uzzambutt/NorthernStudios-RX-Micro-ELRS-Receiver-2.4GHz/Schematic/NS ELRS RX MICRO.pdf

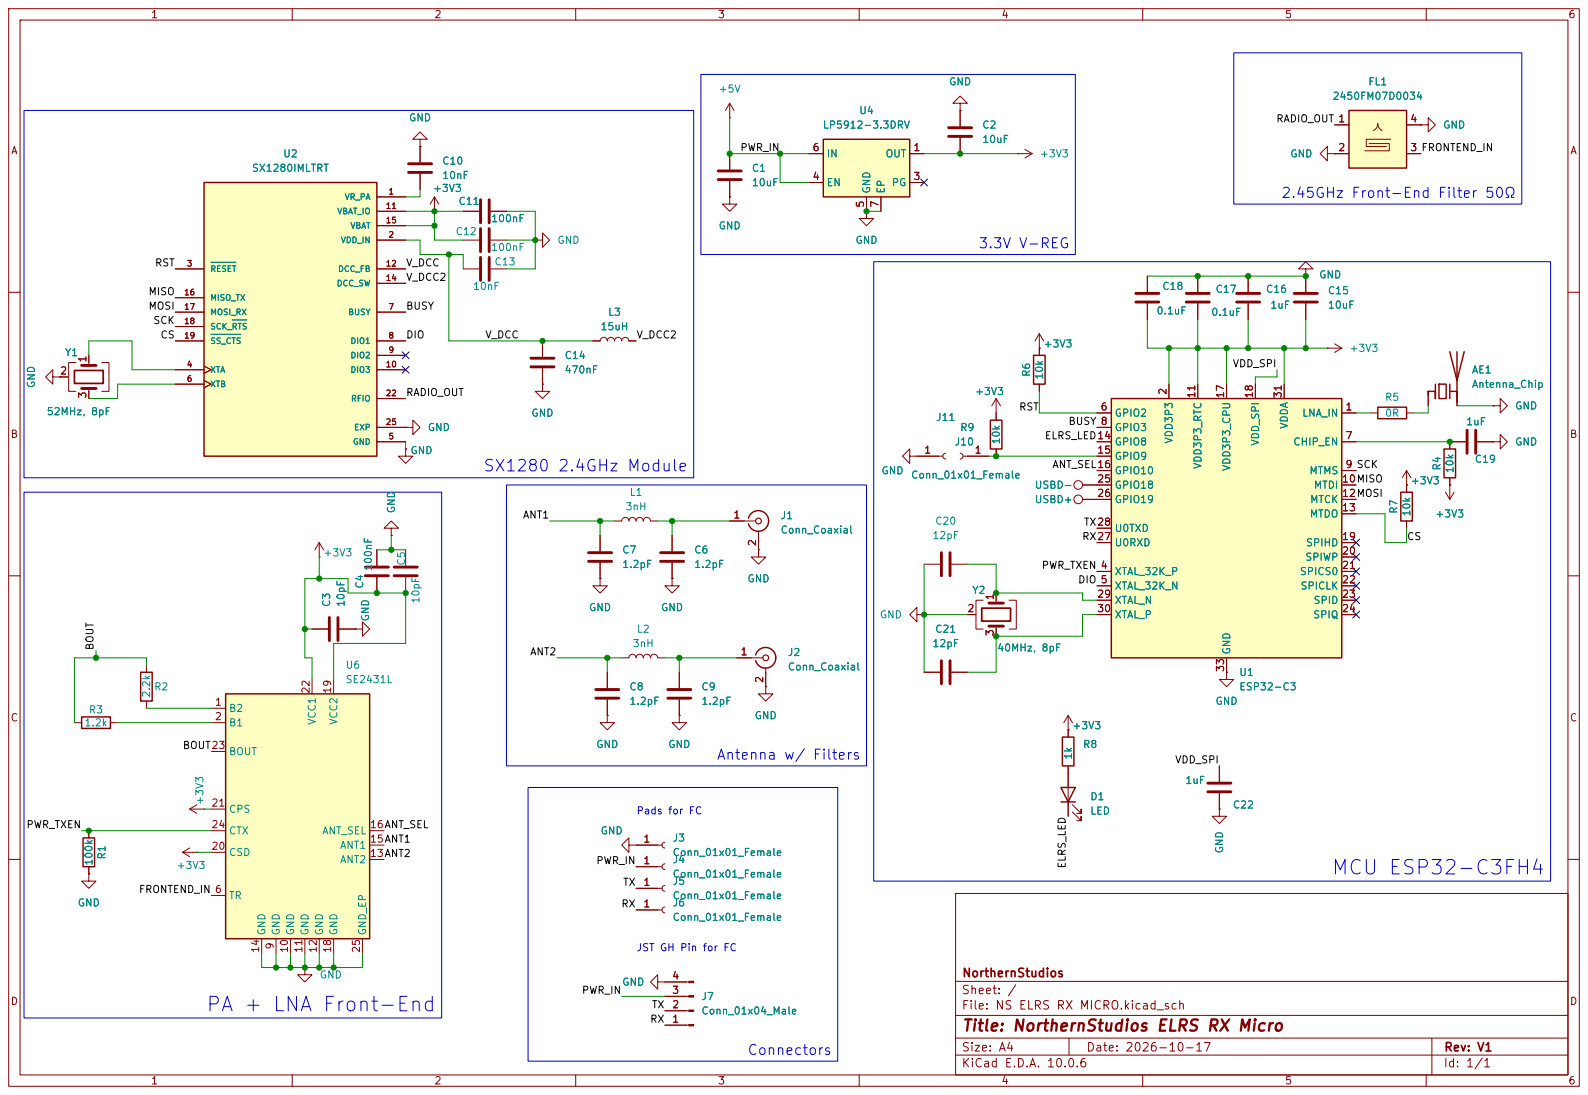
[picture p5: page 1]

CS RST MOSI MISO

JST GH Pin for FC

NorthernStudios
Sheet: /
File: NS ELRS RX MICRO.kicad_sch
Title: NorthernStudios ELRS RX Micro

PA + LNA Front-End

Size: A4 | Rev: V1
KiCad E.D.A. 10.0.6 | Id: 1/1
