uzzambutt/NorthernStudios-RX-Micro-ELRS-Receiver-2.4GHz/NS ELRS RX MICRO.kicad_pcb

## KiCad design NS ELRS RX MICRO.kicad_pcb (2026-10-26)

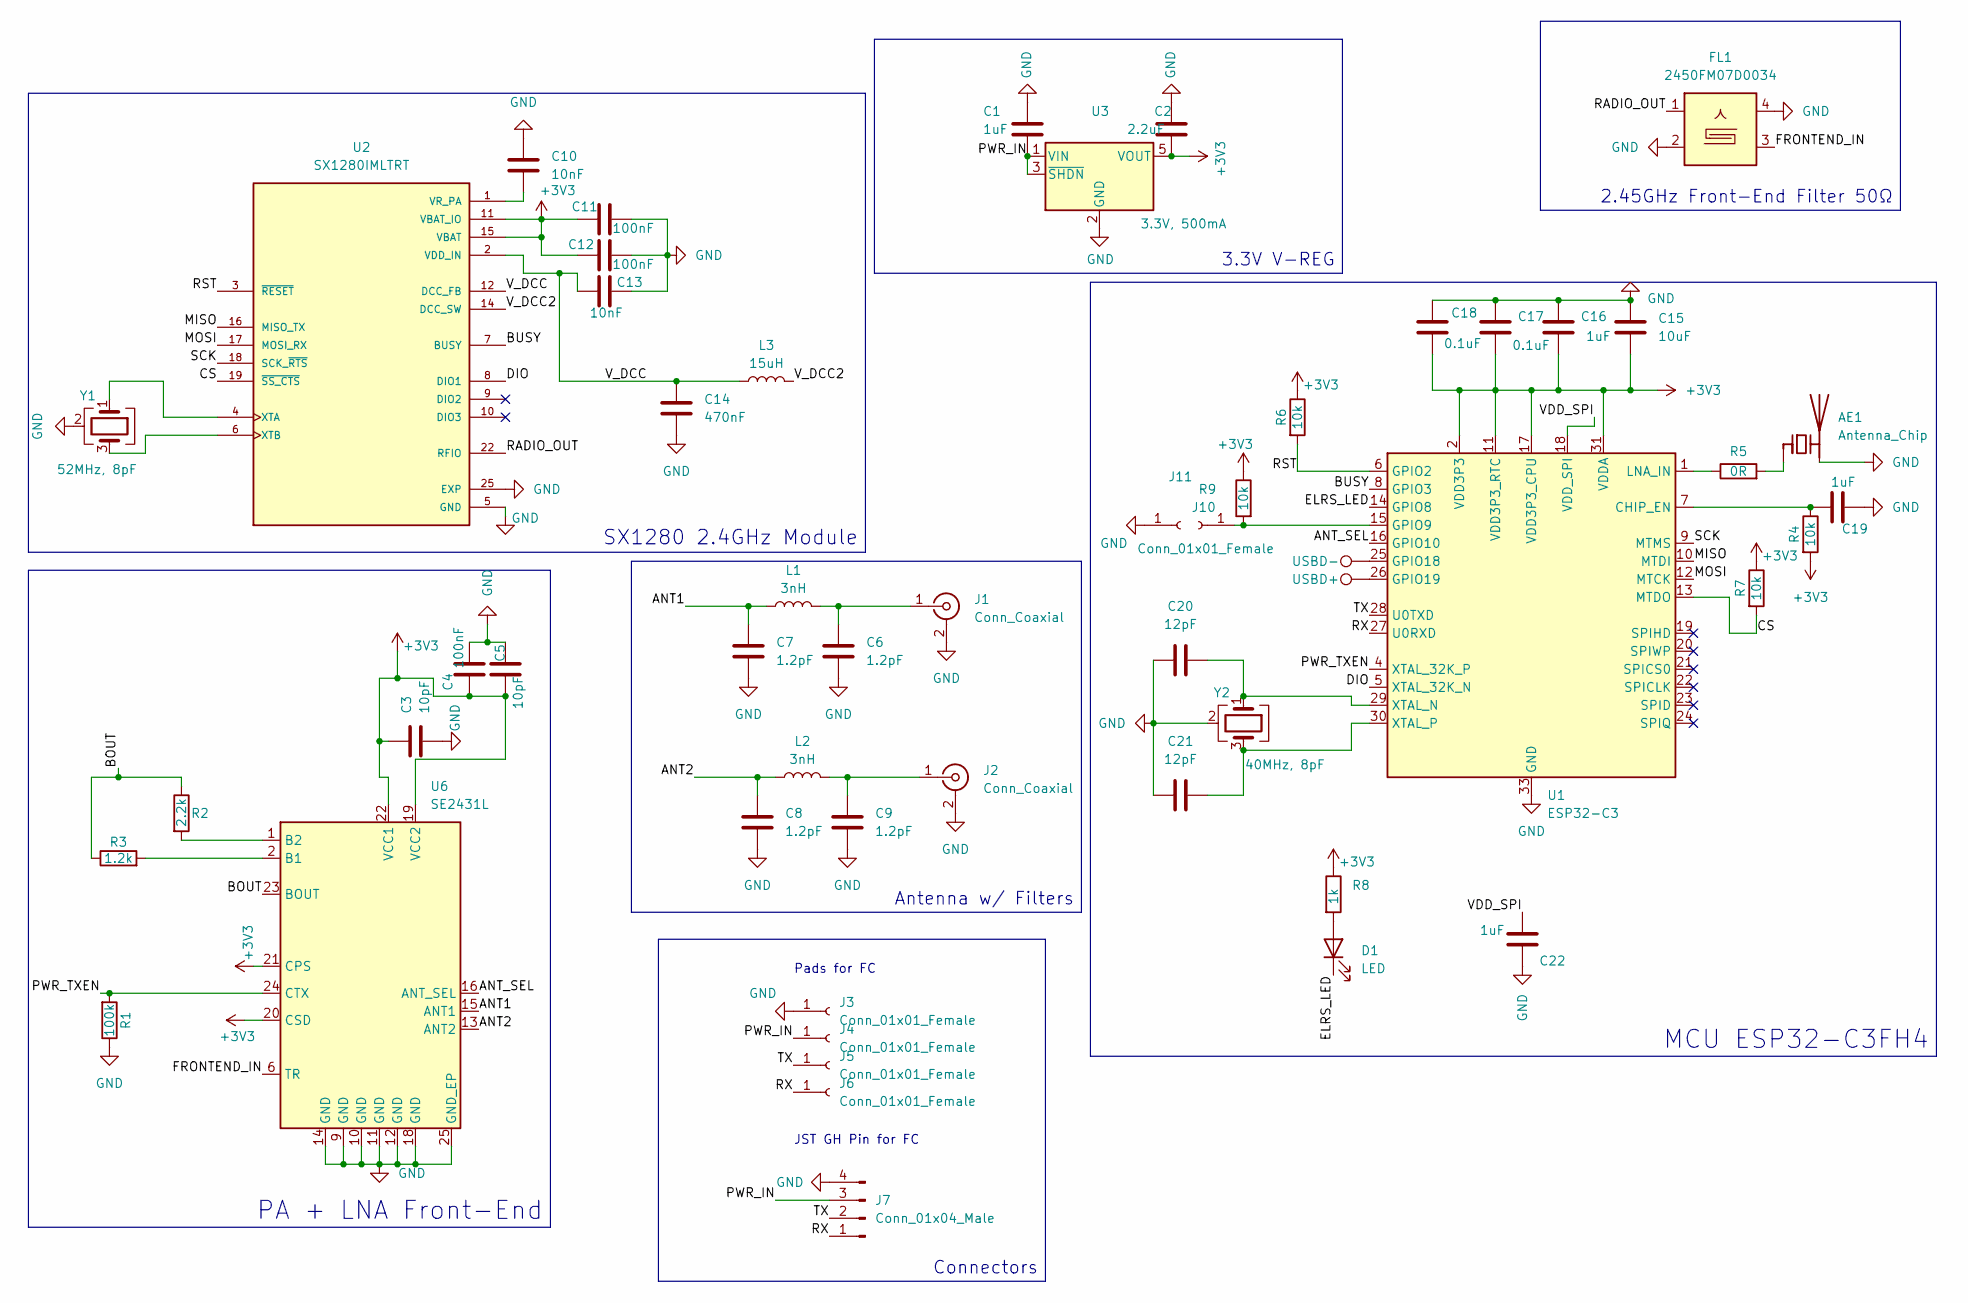
[picture p6: schematic NS ELRS RX MICRO.kicad_sch, NorthernStudios ELRS RX Micro]

Parts:
AE1: Antenna_Chip; Johanson_2450AT18x100
C1: 1uF; C_0402_1005Metric; LCSC C52923
C2: 2.2uF; C_0402_1005Metric; LCSC C12530
C3, C5: 10pF; C_0402_1005Metric
C4, C11, C12: 100nF; C_0402_1005Metric
C6, C7, C8, C9: 1.2pF; C_0402_1005Metric
C10, C13: 10nF; C_0402_1005Metric
C14: 470nF; C_0402_1005Metric
C15: 10uF; C_0402_1005Metric
C16, C19, C22: 1uF; C_0402_1005Metric
C17, C18: 0.1uF; C_0402_1005Metric
C20, C21: 12pF; C_0402_1005Metric
D1: LED; LED_0603_1608Metric
FL1: 2450FM07D0034
J1, J2: Conn_Coaxial; U.FL_Hirose_U.FL-R-SMT-1_Vertical
J3, J4, J5, J6: Conn_01x01_Female; TestPoint_Pad_2.5x2.5mm
J7: Conn_01x04_Male; JST_GH_SM04B-GHS-TB_1x04-1MP_P1.25mm_Horizontal; LCSC C189895
J10, J11: Conn_01x01_Female; TestPoint_Pad_1.0x1.0mm
L1, L2: 3nH; L_0402_1005Metric
L3: 15uH; L_0805_2012Metric
R1: 100k; R_0402_1005Metric
R2: 2.2k; R_0402_1005Metric
R3: 1.2k; R_0402_1005Metric
R4, R6, R7: 10k; R_0402_1005Metric
R5: 0R; R_0201_0603Metric
R8: 1k; R_0201_0603Metric
R9: 10k; R_0402_1005Metric; LCSC C25744
TP1: USBD-; TestPoint_Pad_1.0x1.0mm
TP2: USBD+; TestPoint_Pad_1.0x1.0mm
U1: ESP32-C3; QFN-32-1EP_5x5mm_P0.5mm_EP3.7x3.7mm
U2: SX1280IMLTRT; XCVR_SX1280IMLTRT; PARTREV 3.3
U3: 3.3V, 500mA; TSOT-23-5; Part TPRT9013-33GB; LCSC C587158
U6: SE2431L; QFN-24-1EP_3x4mm_P0.4mm_EP1.65x2.65mm; Digikey 863-1347-2-ND
Y1: 52MHz, 8pF; Crystal_SMD_2016-4Pin_2.0x1.6mm
Y2: 40MHz, 8pF; Crystal_SMD_2520-4Pin_2.5x2.0mm

Connections:
+3V3: C2.2, C3.1, C4.1, C5.1, C11.2, C12.2, C15.2, C16.2, C17.2, C18.2, R4.2, R6.1, R7.1, R8.1, R9.1, U1.2 (VDD3P3), U1.3 (VDD3P3), U1.11 (VDD3P3_RTC), U1.17 (VDD3P3_CPU), U1.31 (VDDA), U1.32 (VDDA), U2.11 (VBAT_IO), U2.15 (VBAT), U3.5 (VOUT), U6.19 (VCC2), U6.20 (CSD), U6.21 (CPS), U6.22 (VCC1)
/ANT1: C7.1, L1.1, U6.15 (ANT1)
/ANT2: C8.1, L2.1, U6.13 (ANT2)
/ANT_SEL: U1.16 (GPIO10), U6.16 (ANT_SEL)
/BOUT: R2.1, R3.1, U6.23 (BOUT)
/BUSY: U1.8 (GPIO3), U2.7 (BUSY)
/CS: R7.2, U1.13 (MTDO), U2.19 (~SS_CTS)
/DIO: U1.5 (XTAL_32K_N), U2.8 (DIO1)
/ELRS_LED: D1.1 (K), U1.14 (GPIO8)
/FRONTEND_IN: FL1.3, U6.6 (TR)
/MISO: U1.10 (MTDI), U2.16 (MISO_TX)
/MOSI: U1.12 (MTCK), U2.17 (MOSI_RX)
/PWR_IN: C1.2, J4.1, J7.3, U3.1 (VIN), U3.3 (~SHDN); also elsewhere on the board
/PWR_TXEN: R1.2, U1.4 (XTAL_32K_P), U6.24 (CTX)
/RADIO_OUT: FL1.1, U2.22 (RFIO)
/RST: R6.2, U1.6 (GPIO2), U2.3 (~RESET)
/RX: J6.1, J7.1, U1.27 (U0RXD); also elsewhere on the board
/SCK: U1.9 (MTMS), U2.18 (SCK_~RTS)
/TX: J5.1, J7.2, U1.28 (U0TXD); also elsewhere on the board
/VDD_SPI: C22.1, U1.18 (VDD_SPI)
/V_DCC: C13.2, C14.1, L3.1, U2.2 (VDD_IN), U2.12 (DCC_FB)
/V_DCC2: L3.2, U2.14 (DCC_SW)
GND: AE1.2 (PCB_Trace), C1.1, C2.1, C3.2, C4.2, C5.2, C6.2, C7.2, C8.2, C9.2, C10.2, C11.1, C12.1, C13.1, C14.2, C15.1, C16.1, C17.1, C18.1, C19.1, C20.1, C21.1, C22.2, FL1.2, FL1.4, FL1.5, J1.2 (Ext), J2.2 (Ext), J3.1 (Pin_1_1), J7.4, J11.1 (Pin_1_1), R1.1, U1.33 (GND), U2.5 (GND), U2.13 (GND), U2.20 (GND), U2.21 (GND), U2.23 (GND), U2.24 (GND), U2.25 (EXP), U3.2 (GND), U6.9 (GND), U6.10 (GND), U6.11 (GND), U6.12 (GND), U6.14 (GND), U6.18 (GND), U6.25 (GND_EP), Y1.2 (G), Y1.4 (G), Y2.2 (G), Y2.4 (G)
unnamed: AE1.1 (FEED), R5.2
unnamed: D1.2 (A), R8.2
unnamed: C6.1, J1.1 (In), L1.2
unnamed: C9.1, J2.1 (In), L2.2
unnamed: J10.1 (Pin_1_1), R9.2, U1.15 (GPIO9)
unnamed: C19.2, R4.1, U1.7 (CHIP_EN)
unnamed 29: TP1.1, U1.25 (GPIO18); also elsewhere on the board
unnamed 30: TP2.1, U1.26 (GPIO19); also elsewhere on the board
unnamed: R5.1, U1.1 (LNA_IN)
unnamed: C20.2, U1.29 (XTAL_N), Y2.1
unnamed: C21.2, U1.30 (XTAL_P), Y2.3
unnamed: C10.1, U2.1 (VR_PA)
unnamed: U2.4 (XTA), Y1.1
unnamed: U2.6 (XTB), Y1.3
unnamed: R3.2, U6.2 (B1)
unnamed: R2.2, U6.1 (B2)

Notes on the sheet:
JST GH Pin for FC
Pads for FC
MCU ESP32-C3FH4
SX1280 2.4GHz Module
PA + LNA Front-End
2.45GHz Front-End Filter 50Ω
3.3V V-REG
Antenna w/ Filters
Connectors

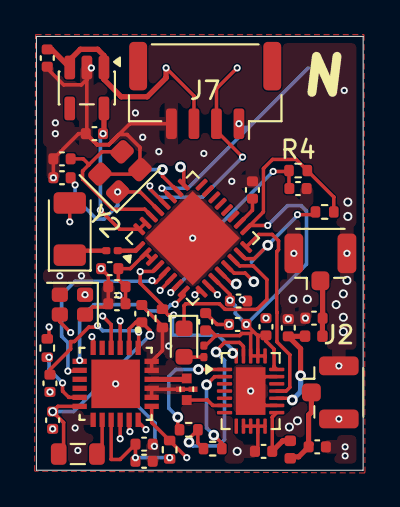
[picture p7: board NS ELRS RX MICRO.kicad_pcb from above]

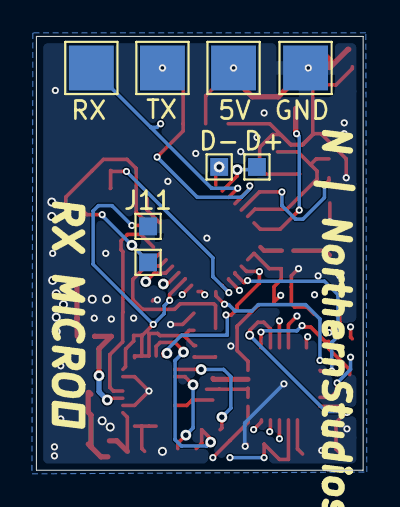
[picture p8: board NS ELRS RX MICRO.kicad_pcb from below]

Board: 4 copper layers, 18.2 x 24.1 mm, 54 parts (8 on the bottom side), 39 nets.

Other parts of the board:
5V: Conn_01x01_Female; TestPoint_Pad_2.5x2.5mm
D+: USBD+; TestPoint_Pad_1.0x1.0mm
D-: USBD-; TestPoint_Pad_1.0x1.0mm
RX: Conn_01x01_Female; TestPoint_Pad_2.5x2.5mm
TX: Conn_01x01_Female; TestPoint_Pad_2.5x2.5mm

Their connections:
/PWR_IN: 5V.1 (Pin_1_1); also elsewhere on the board
/RX: RX.1 (Pin_1_1); also elsewhere on the board
/TX: TX.1 (Pin_1_1); also elsewhere on the board
unnamed 29: D-.1 (1_1); also elsewhere on the board
unnamed 30: D+.1 (1_1); also elsewhere on the board
