uzzambutt/NorthernStudios-RX-Micro-ELRS-Receiver-2.4GHz/(commit log)

2026-10-17 added two symbols
    [NS ELRS RX MICRO.kicad_pcb, NS ELRS RX MICRO.kicad_sch]
2026-10-21 80pct schematic drawn
    [NS ELRS RX MICRO.kicad_sch]
2026-10-21 more updates!
    [NS ELRS RX MICRO.kicad_sch]
2026-10-25 completed schematic
    [NS ELRS RX MICRO.kicad_sch]
2026-10-25 completed pcb routing
    [NS ELRS RX MICRO.kicad_pcb, NS ELRS RX MICRO.kicad_sch]
2026-10-26 fixed some errors
    [NS ELRS RX MICRO.kicad_pcb]
