uzzambutt/NorthernStudios-RX-Micro-ELRS-Receiver-2.4GHz/(notices)

Notices in the files:
README.md:
License: CERN-OHL-S-v2
